7ingsong/stm32-tayloe-sdr/docs/fft.png

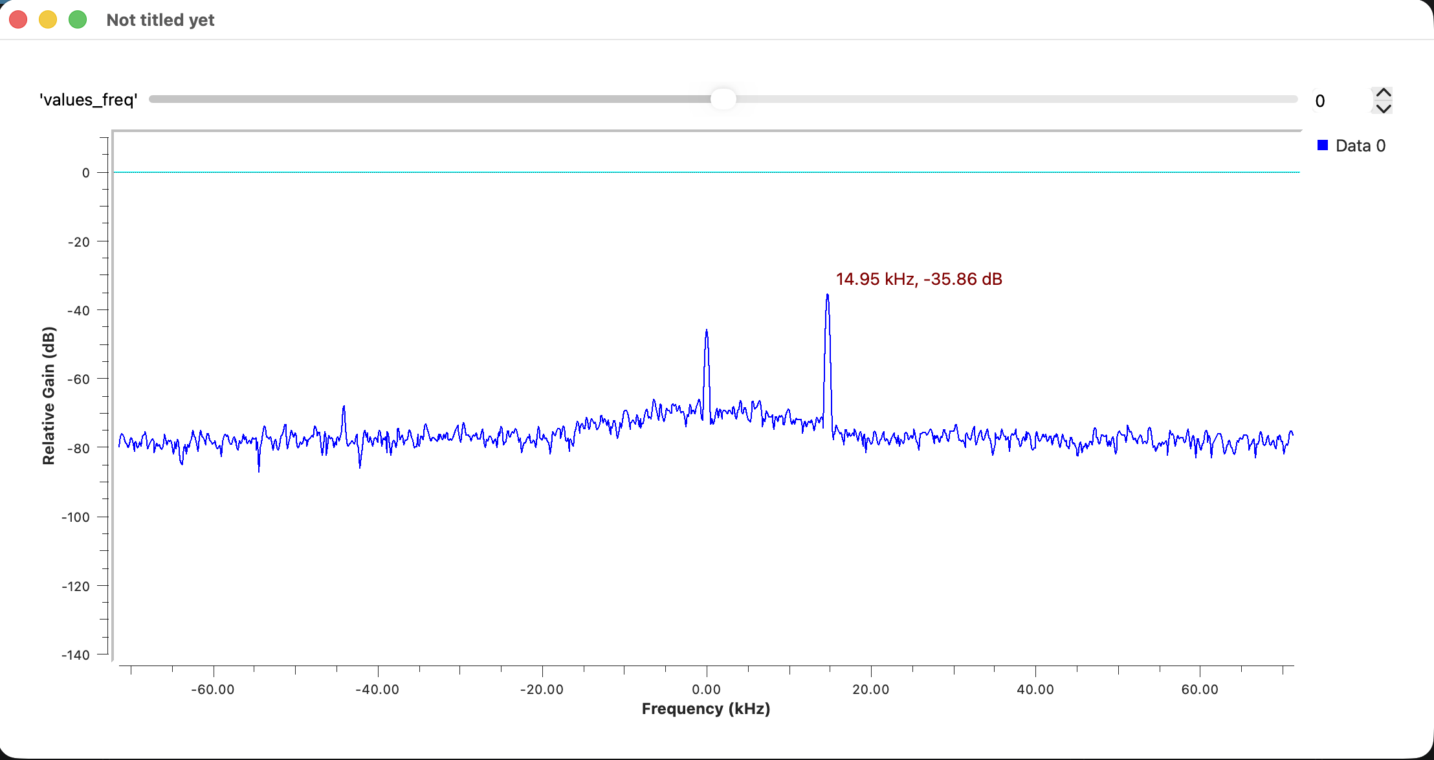
docs/fft.png
