7ingsong/stm32-tayloe-sdr/docs/pcb-1-layer.jpg

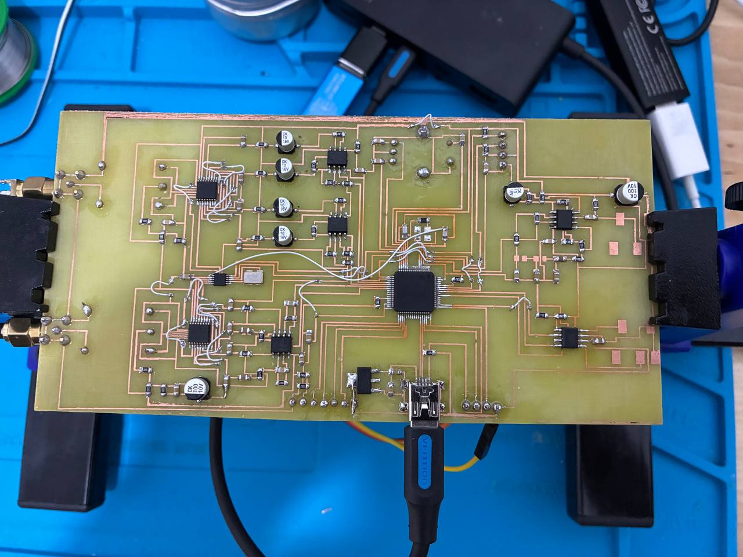
docs/pcb-1-layer.jpg
