7ingsong/stm32-tayloe-sdr/client/radio_iq_rx.py

#!/usr/bin/env python3
# -*- coding: utf-8 -*-

#
# SPDX-License-Identifier: GPL-3.0
#
# GNU Radio Python Flow Graph
# Title: Not titled yet
# Author: singsong
# GNU Radio version: 3.10.12.0

from PyQt5 import Qt
from gnuradio import qtgui
from PyQt5 import QtCore
from gnuradio import analog
from gnuradio import audio
from gnuradio import blocks
from gnuradio import gr
from gnuradio.filter import firdes
from gnuradio.fft import window
import sys
import signal
from PyQt5 import Qt
from argparse import ArgumentParser
from gnuradio.eng_arg import eng_float, intx
from gnuradio import eng_notation
from gnuradio import network
from gnuradio.filter import pfb
import sip
import threading



class radio_iq_rx(gr.top_block, Qt.QWidget):

    def __init__(self):
        gr.top_block.__init__(self, "Not titled yet", catch_exceptions=True)
        Qt.QWidget.__init__(self)
        self.setWindowTitle("Not titled yet")
        qtgui.util.check_set_qss()
        try:
            self.setWindowIcon(Qt.QIcon.fromTheme('gnuradio-grc'))
        except BaseException as exc:
            print(f"Qt GUI: Could not set Icon: {str(exc)}", file=sys.stderr)
        self.top_scroll_layout = Qt.QVBoxLayout()
        self.setLayout(self.top_scroll_layout)
        self.top_scroll = Qt.QScrollArea()
        self.top_scroll.setFrameStyle(Qt.QFrame.NoFrame)
        self.top_scroll_layout.addWidget(self.top_scroll)
        self.top_scroll.setWidgetResizable(True)
        self.top_widget = Qt.QWidget()
        self.top_scroll.setWidget(self.top_widget)
        self.top_layout = Qt.QVBoxLayout(self.top_widget)
        self.top_grid_layout = Qt.QGridLayout()
        self.top_layout.addLayout(self.top_grid_layout)

        self.settings = Qt.QSettings("gnuradio/flowgraphs", "radio_iq_rx")

        try:
            geometry = self.settings.value("geometry")
            if geometry:
                self.restoreGeometry(geometry)
        except BaseException as exc:
            print(f"Qt GUI: Could not restore geometry: {str(exc)}", file=sys.stderr)
        self.flowgraph_started = threading.Event()

        ##################################################
        # Variables
        ##################################################
        self.value = value = 0
        self.samp_rate2 = samp_rate2 = 48e3
        self.samp_rate = samp_rate = 64000

        ##################################################
        # Blocks
        ##################################################

        self._value_range = qtgui.Range(-samp_rate//2, samp_rate//2, 1, 0, 200)
        self._value_win = qtgui.RangeWidget(self._value_range, self.set_value, "'value'", "counter_slider", float, QtCore.Qt.Horizontal)
        self.top_layout.addWidget(self._value_win)
        self.qtgui_freq_sink_x_0 = qtgui.freq_sink_c(
            1024, #size
            window.WIN_BLACKMAN_hARRIS, #wintype
            0, #fc
            samp_rate, #bw
            "", #name
            1,
            None # parent
        )
        self.qtgui_freq_sink_x_0.set_update_time(0.10)
        self.qtgui_freq_sink_x_0.set_y_axis((-140), 10)
        self.qtgui_freq_sink_x_0.set_y_label('Relative Gain', 'dB')
        self.qtgui_freq_sink_x_0.set_trigger_mode(qtgui.TRIG_MODE_FREE, 0.0, 0, "")
        self.qtgui_freq_sink_x_0.enable_autoscale(False)
        self.qtgui_freq_sink_x_0.enable_grid(False)
        self.qtgui_freq_sink_x_0.set_fft_average(1.0)
        self.qtgui_freq_sink_x_0.enable_axis_labels(True)
        self.qtgui_freq_sink_x_0.enable_control_panel(False)
        self.qtgui_freq_sink_x_0.set_fft_window_normalized(False)



        labels = ['', '', '', '', '',
            '', '', '', '', '']
        widths = [1, 1, 1, 1, 1,
            1, 1, 1, 1, 1]
        colors = ["blue", "red", "green", "black", "cyan",
            "magenta", "yellow", "dark red", "dark green", "dark blue"]
        alphas = [1.0, 1.0, 1.0, 1.0, 1.0,
            1.0, 1.0, 1.0, 1.0, 1.0]

        for i in range(1):
            if len(labels[i]) == 0:
                self.qtgui_freq_sink_x_0.set_line_label(i, "Data {0}".format(i))
            else:
                self.qtgui_freq_sink_x_0.set_line_label(i, labels[i])
            self.qtgui_freq_sink_x_0.set_line_width(i, widths[i])
            self.qtgui_freq_sink_x_0.set_line_color(i, colors[i])
            self.qtgui_freq_sink_x_0.set_line_alpha(i, alphas[i])

        self._qtgui_freq_sink_x_0_win = sip.wrapinstance(self.qtgui_freq_sink_x_0.qwidget(), Qt.QWidget)
        self.top_layout.addWidget(self._qtgui_freq_sink_x_0_win)
        self.pfb_arb_resampler_xxx_0 = pfb.arb_resampler_ccf(
            (samp_rate2/samp_rate),
            taps=None,
            flt_size=32,
            atten=100)
        self.pfb_arb_resampler_xxx_0.declare_sample_delay(0)
        self.pfb_arb_resampler_xxx_0.set_max_output_buffer(2048)
        self.network_udp_source_0 = network.udp_source(gr.sizeof_gr_complex, 1, 2001, 0, 512, False, False, False)
        self.network_udp_source_0.set_max_output_buffer(2048)
        self.blocks_multiply_xx_0 = blocks.multiply_vcc(1)
        self.blocks_multiply_xx_0.set_max_output_buffer(2048)
        self.blocks_complex_to_imag_0 = blocks.complex_to_imag(1)
        self.blocks_complex_to_imag_0.set_max_output_buffer(2048)
        self.audio_sink_0 = audio.sink(48000, '', True)
        self.analog_sig_source_x_0 = analog.sig_source_c(samp_rate, analog.GR_COS_WAVE, value, 1, 0, 0)


        ##################################################
        # Connections
        ##################################################
        self.connect((self.analog_sig_source_x_0, 0), (self.blocks_multiply_xx_0, 1))
        self.connect((self.blocks_complex_to_imag_0, 0), (self.audio_sink_0, 0))
        self.connect((self.blocks_multiply_xx_0, 0), (self.pfb_arb_resampler_xxx_0, 0))
        self.connect((self.blocks_multiply_xx_0, 0), (self.qtgui_freq_sink_x_0, 0))
        self.connect((self.network_udp_source_0, 0), (self.blocks_multiply_xx_0, 0))
        self.connect((self.pfb_arb_resampler_xxx_0, 0), (self.blocks_complex_to_imag_0, 0))


    def closeEvent(self, event):
        self.settings = Qt.QSettings("gnuradio/flowgraphs", "radio_iq_rx")
        self.settings.setValue("geometry", self.saveGeometry())
        self.stop()
        self.wait()

        event.accept()

    def get_value(self):
        return self.value

    def set_value(self, value):
        self.value = value
        self.analog_sig_source_x_0.set_frequency(self.value)

    def get_samp_rate2(self):
        return self.samp_rate2

    def set_samp_rate2(self, samp_rate2):
        self.samp_rate2 = samp_rate2
        self.pfb_arb_resampler_xxx_0.set_rate((self.samp_rate2/self.samp_rate))

    def get_samp_rate(self):
        return self.samp_rate

    def set_samp_rate(self, samp_rate):
        self.samp_rate = samp_rate
        self.analog_sig_source_x_0.set_sampling_freq(self.samp_rate)
        self.pfb_arb_resampler_xxx_0.set_rate((self.samp_rate2/self.samp_rate))
        self.qtgui_freq_sink_x_0.set_frequency_range(0, self.samp_rate)




def main(top_block_cls=radio_iq_rx, options=None):

    qapp = Qt.QApplication(sys.argv)

    tb = top_block_cls()

    tb.start()
    tb.flowgraph_started.set()

    tb.show()

    def sig_handler(sig=None, frame=None):
        tb.stop()
        tb.wait()

        Qt.QApplication.quit()

    signal.signal(signal.SIGINT, sig_handler)
    signal.signal(signal.SIGTERM, sig_handler)

    timer = Qt.QTimer()
    timer.start(500)
    timer.timeout.connect(lambda: None)

    qapp.exec_()

if __name__ == '__main__':
    main()
