7ingsong/stm32-tayloe-sdr/inc/si5351.h

// vim: set ai et ts=4 sw=4:
#ifndef _SI5351_H_
#define _SI5351_H_
#include <stdint.h>

typedef enum {
    SI5351_PLL_A = 0,
    SI5351_PLL_B,
} si5351PLL_t;

typedef enum {
    SI5351_R_DIV_1   = 0,
    SI5351_R_DIV_2   = 1,
    SI5351_R_DIV_4   = 2,
    SI5351_R_DIV_8   = 3,
    SI5351_R_DIV_16  = 4,
    SI5351_R_DIV_32  = 5,
    SI5351_R_DIV_64  = 6,
    SI5351_R_DIV_128 = 7,
} si5351RDiv_t;

typedef enum {
    SI5351_DRIVE_STRENGTH_2MA = 0x00, //  ~ 2.2 dBm
    SI5351_DRIVE_STRENGTH_4MA = 0x01, //  ~ 7.5 dBm
    SI5351_DRIVE_STRENGTH_6MA = 0x02, //  ~ 9.5 dBm
    SI5351_DRIVE_STRENGTH_8MA = 0x03, // ~ 10.7 dBm
} si5351DriveStrength_t;

typedef struct {
    int32_t mult;
    int32_t num;
    int32_t denom;
} si5351PLLConfig_t;

typedef struct {
    uint8_t allowIntegerMode;
    int32_t div;
    int32_t num;
    int32_t denom;
    si5351RDiv_t rdiv;
} si5351OutputConfig_t;

/*
 * Basic interface allows to use only CLK0 and CLK2.
 * This interface uses separate PLLs for both CLK0 and CLK2 thus the frequencies
 * can be changed independently. If you also need CLK1 one PLL should
 * be shared between two CLKx and things get a little more complicated.
 * CLK0 and CLK2 were chosen because they are distant from each other on a common
 * Si5351 module. This makes using them a little more convenient than CLK0 and CLK1.
 */
void si5351_Init(int32_t correction);
void si5351_SetupCLK0(int32_t Fclk, si5351DriveStrength_t driveStrength);
void si5351_SetupCLK1(int32_t Fclk, si5351DriveStrength_t driveStrength);
void si5351_SetupCLK2(int32_t Fclk, si5351DriveStrength_t driveStrength);
void si5351_EnableOutputs(uint8_t enabled);

/*
 * Advanced interface. Use it if you need:
 *
 * a. CLK0, CLK1 and CLK2 simultaneously;
 * b. A phase shift 90° between two channels;
 *
 * si5351_Calc() always uses 900 MHz PLL for frequencies below 81 MHz.
 * This PLL can safely be shared between all CLKx that work @ <= 81 MHz.
 * You can also modify si5351.c to share one PLL for any frequencies <= 112.5 MHz,
 * however this will increase the worse case calculation error to 13 Hz.
 */
void si5351_Calc(int32_t Fclk, si5351PLLConfig_t* pll_conf, si5351OutputConfig_t* out_conf);

/*
 * si5351_CalcIQ() finds PLL and MS parameters that give phase shift 90° between two channels,
 * if 0 and (uint8_t)out_conf.div are passed as phaseOffset for these channels. Channels should
 * use the same PLL to make it work.
 */
void si5351_CalcIQ(int32_t Fclk, si5351PLLConfig_t* pll_conf, si5351OutputConfig_t* out_conf);

void si5351_SetupPLL(si5351PLL_t pll, si5351PLLConfig_t* conf);
int si5351_SetupOutput(uint8_t output, si5351PLL_t pllSource, si5351DriveStrength_t driveStength, si5351OutputConfig_t* conf, uint8_t phaseOffset);

void si5351_init();
void si5351_clk2_8mhz();
// LO-Q phase trim (steps of 90/div deg, ~1 deg at 10 MHz) to correct I/Q quadrature skew on the board.
// +6 was found by sweeping at 10 MHz in duplex: it took the TX->RX image from +1 dB to -10 dB.
// In degrees it scales with frequency (~3 deg per step at 30 MHz), so other bands may want another value.
#ifndef SI5351_PHASE_TRIM_DEFAULT
#define SI5351_PHASE_TRIM_DEFAULT 6
#endif
extern volatile int8_t si5351_phase_trim;

// Queues the I/Q LO retune; si5351_poll() writes it out in short I2C bursts from the main loop
void si5351_set_frequency(int32_t frequency, si5351DriveStrength_t strength);
void si5351_set_frequency_blocking(int32_t frequency, si5351DriveStrength_t strength);
int si5351_poll(void); // 1 when nothing is pending

#endif
