7ingsong/stm32-tayloe-sdr/inc/stm32_it.h

/**
  ******************************************************************************
  * @file    stm32_it.h
  * @author  MCD Application Team
  * @version V4.1.0
  * @date    26-May-2017
  * @brief   This file contains the headers of the interrupt handlers.
  ******************************************************************************
  * @attention
  *
  * <h2><center>&copy; COPYRIGHT(c) 2017 STMicroelectronics</center></h2>
  *
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
  ******************************************************************************
  */


/* Define to prevent recursive inclusion -------------------------------------*/
#ifndef __STM32_IT_H
#define __STM32_IT_H

/* Includes ------------------------------------------------------------------*/
//#include "platform_config.h"

/* Exported types ------------------------------------------------------------*/
/* Exported constants --------------------------------------------------------*/
/* Exported macro ------------------------------------------------------------*/
/* Exported functions ------------------------------------------------------- */

void NMI_Handler(void);
void HardFault_Handler(void);
void MemManage_Handler(void);
void BusFault_Handler(void);
void UsageFault_Handler(void);
void SVC_Handler(void);
void DebugMon_Handler(void);
void PendSV_Handler(void);
void SysTick_Handler(void);
void USBWakeUp_IRQHandler(void);
void USB_FS_WKUP_IRQHandler(void);

#endif /* __STM32_IT_H */

/************************ (C) COPYRIGHT STMicroelectronics *****END OF FILE****/
