7ingsong/stm32-tayloe-sdr/src/stm32_it.c

#include "hw_config.h"
#include "stm32_it.h"
#include "usb_lib.h"
#include "usb_istr.h"
#include "stm32f10x_rcc.h"

#include <stm32f10x_exti.h>

void NMI_Handler(void)
{
    if (RCC_GetITStatus(RCC_IT_CSS) != RESET){
        RCC_ClearITPendingBit(RCC_IT_CSS);
    }
}

void HardFault_Handler(void)
{
    while (1)
    {
    }
}

void MemManage_Handler(void)
{
    while (1)
    {
    }
}

void BusFault_Handler(void)
{
    while (1)
    {
    }
}

void UsageFault_Handler(void)
{
    while (1)
    {
    }
}

void SVC_Handler(void)
{
}

void DebugMon_Handler(void)
{
}

void PendSV_Handler(void)
{
}

/*
void SysTick_Handler(void)
{
}
*/

#if defined(STM32L1XX_MD) || defined(STM32L1XX_HD)|| defined(STM32L1XX_MD_PLUS)|| defined (STM32F37X)
void USB_LP_IRQHandler(void)
#else
void USB_LP_CAN1_RX0_IRQHandler(void)
#endif
{
    USB_Istr();
}

#if defined(STM32L1XX_MD) || defined(STM32L1XX_HD)|| defined(STM32L1XX_MD_PLUS)
void USB_FS_WKUP_IRQHandler(void)
#else
void USBWakeUp_IRQHandler(void)
#endif
{
    EXTI_ClearITPendingBit(EXTI_Line18);
}
