7ingsong/stm32-tayloe-sdr/inc/ui.h

#ifndef _UI
#define _UI

/*
 * Front panel: 0.91" SSD1306 OLED (128x32, I2C1 shared with the Si5351) and the EC11 encoder.
 * Turn = tune the LO by the current step, short push = next step (10 Hz .. 1 MHz),
 * long push = toggle RX/TX (same as CMD_PTT).
 * Shows the frequency (step digit underlined) and RX/TX; host changes (CMD_SET_FREQ, CMD_PTT) show up too.
 */

// Set to 1 if turning clockwise tunes down
#ifndef UI_ENCODER_REVERSE
#define UI_ENCODER_REVERSE 0
#endif

// 1 = switch the OLED off while transmitting. Its row scan (~312 Hz) pulls pulsed current from 3.3 V and
// the ripple reached the mic preamp as a hum comb (+17 dB). Off by default while testing an RC filter on the
// preamp supply; set to 1 if the hum is back.
#ifndef UI_BLANK_ON_TX
#define UI_BLANK_ON_TX 0
#endif

// Hold the encoder button this long to toggle RX/TX; it fires while still held
#ifndef UI_LONG_PRESS_MS
#define UI_LONG_PRESS_MS 700
#endif

void ui_init(void);  // after clock_init() and iq_set_frequency(); blocks ~20 ms to bring up the display
void ui_poll(void);  // every main-loop pass; never blocks for more than one ~0.5 ms I2C chunk

#endif
