7ingsong/stm32-tayloe-sdr/(commit log)

2026-10-01 Remove LED
2026-10-07 add display and encoder
2026-10-07 add TX and RX switch
